makkaraayush/quad-commutation-testbed/docs/testing_logs/test_06/README.md

# Test 06: ArduPilot Stabilization & Attitude Control Test

**Date:** October 6, 2026  
**Result:** Passed (Smooth liftoff, rock-solid attitude stabilization, zero wobble, gentle touchdown)  
**Setup:** Untethered indoor flight on floor  

---

## Why I Did This Test
With Test 05 confirming safe arming and motor synchronization, the next critical hurdle was verifying flight dynamics and attitude stabilization under ArduPilot in **Stabilize** mode. 

On Betaflight, getting this 500mm frame with heavy 10-inch props to hover without severe oscillations required drastic lowpass filtering and heavily nerfed PID gains due to phase lag from the analog ESCs. This test was designed to see how ArduPilot's attitude control and rate loops handle the frame dynamics in free flight.

---

## The Whiteboard Breakdown
Here is the whiteboard setup for this run:

* **Goal:** Achieve Successful Flight
* **Description:** Stabilization Test
* **Hardware Stack:**
  * Frame: TBS 500 Clone
  * FC: DakeFPV F405
  * ESCs: 30A Analog (SimonK/BLHeli, 480Hz PWM)
  * Motors: 4x 2212 1000KV (1045 props)
  * Battery: 3S 2200mAh LiPo
  * Radio: FlySky FS-i6 TX / FS-iA6B RX (i-BUS)
  * GPS: M10Q
* **Firmware:** ArduPilot Custom Firmware
* **Tuning:** Custom

---

## What Happened in the Test Video

You can watch the recording here: [Test 06 Video Recording](test_06_stabilization_test.mp4)

Here is how the test went down:

1. **Liftoff:** Raised throttle smoothly; the quad lifted off cleanly from the floor into a steady eye-level hover without pulling or drifting aggressively.
2. **Attitude Stabilization:** ArduPilot's self-leveling controller held the frame level and composed. There was zero trace of the violent wobble seen in earlier Betaflight tests.
3. **Control Authority:** Applied gentle pitch, roll, and yaw inputs to test responsiveness. The drone tracked stick commands predictably and returned to a solid level attitude immediately upon centering sticks.
4. **Touchdown:** Smoothly decreased throttle for a gentle landing on the skids, followed by a clean disarm.

---

## Conclusion
Stabilize mode on ArduPilot is completely verified and rock-solid. Attitude recovery, gyro filtering, and rate response are well-balanced for the 500mm frame and analog ESCs. Ready to test automated altitude control in Alt-Hold mode.
