makkaraayush/quad-commutation-testbed/(commit log)

2026-10-03 Document off-camera bench tuning and M10Q GPS arrival
2026-10-04 Document hardware circuit connections, pinouts, and wiring architecture
2026-10-04 Simplify drone wiring description
2026-10-04 Document mount completions and verify stock ArduPilot hex memory fit
2026-10-04 Document ArduPilot flashing via STM32CubeProgrammer and fix for Betaflight flasher error
2026-10-04 Document Issue 9 on M10Q compass detection and SCL voltage diagnostics
2026-10-04 Document resolution of compass SCL issue via LED_TYPE parameter fix
2026-10-04 Document Issue 10 on analog ESC boot timeout vs ArduPilot startup delay
2026-10-04 Document phone USB-C field startup workaround for legacy ESC boot timeout
2026-10-04 Document ArduCopter motor orientation fix and 5-mode transmitter mixer setup
2026-10-06 Document Test 08 outdoor RTL trials, low-battery failsafe tree snag, and barehanded rescue catch
2026-10-06 Configure battery failsafe to Land and set RTL return altitude to 22m
2026-10-06 Add DIY LoRa telemetry, Bluetooth ground station, Wi-Fi video, and TP4056 3k3 charging guide
2026-10-06 Refine telemetry guide with FS-i6 power switch placement and builder walkthrough
2026-10-08 feat(telemetry): route LoRa RST to GPIO14 on ground and GPIO12 on air unit
2026-10-08 fix(ground-station): remap OLED to D23/D22, LoRa MOSI to D21, and RST to D15
    [ground_diagnostic.ino, ground_station_esp32.ino]
2026-10-08 fix(ground-station): remap LoRa SPI to contiguous block SCK:D5, MISO:D18, MOSI:D19, NSS:D21
    [ground_diagnostic.ino, ground_station_esp32.ino]
2026-10-08 fix(battery): calibrate D34 ADC factor to match 4.02V battery reference
    [ground_diagnostic.ino, ground_station_esp32.ino]
2026-10-08 fix(air-unit): map LoRa SPI to sequential pins IO13, IO15, IO14, IO2 on ESP32-CAM
    [air_unit_esp32_cam.ino]
2026-10-08 docs(air_unit): update header comment pin references for SPI ribbon
2026-10-08 feat(air_unit): add esp_http_server FPV cockpit UI, MJPEG stream, flash PWM, and sensor controls
2026-10-09 fix(telemetry): resolve MAVLink parser deadlock on packets >64 bytes and add real-time packet/byte diagnostics to ground and air units
    [air_unit_esp32_cam.ino, ground_station_esp32.ino]
2026-10-09 feat(diagnostics): add 1Hz AirDiagPacket heartbeat and live LoRa RF + FC UART status to ground OLED
2026-10-09 feat(air_unit): add on-demand video stream toggle to reduce battery and Wi-Fi load
2026-10-09 feat: add live MAVLink OSD + DVR recording to air unit and Option B 14s auto-carousel with alert override to ground station
2026-10-09 fix(ground_station): eliminate character overlap on LORA: NO RF SIGNAL and extend Page 1 HUD to 10 seconds
    [ground_station_esp32.ino]
